juandelacruz-calvo/standing-desk-controller/(commit log)

2026-03-20 Initial commit: standing desk controller with HC-SR04 sensor, 4 buttons, EEPROM memory, closed-loop positioning, and 3D-printable enclosure. CC BY-NC-SA 4.0.
    [enclosure.scad]
2026-03-22 Add third memory button (MEM3) on pin D10
    Adds a third programmable height preset following the same click-to-recall / long-press-to-save pattern. Updates firmware, enclosure (5 buttons + label), and README documentation.
    Made-with: Cursor
    [enclosure.scad]
2026-03-29 Update configuration and code for motor control and button handling
    - Added .history/ and .vscode/ to .gitignore.
    - Changed upload and monitor ports in platformio.ini from COM4 to COM3.
    - Updated motor control logic in main.cpp to use pinMode for motor pins and improved button handling with event logging for better debugging.
2026-03-31 Update project for Wemos D1 Mini support and MQTT integration
    - Changed board configuration in platformio.ini from Arduino Nano to Wemos D1 Mini (ESP8266).
    - Updated README to reflect hardware changes and new features.
    - Added local WiFi/MQTT credentials handling in main.cpp with support for MQTT commands.
    - Adjusted pin assignments for the D1 Mini and updated serial communication speed to 115200 baud.
    - Included secrets.h for managing sensitive information.
2026-05-10 Refactor pin assignments and update sensor handling logic
    - Changed motor down pin from D1 to D8 and memory button pin from D8 to D1.
    - Increased height tolerance from 0.5 cm to 1.5 cm and sensor interval from 100 ms to 200 ms.
    - Added idle log interval for height reporting and improved height smoothing logic in readHeight function.
    - Updated serial output to reflect new pin assignments and current height readings.
    [main.cpp]
2026-05-19 Update platformio.ini and main.cpp for HCSR04 sensor integration and board configuration
    - Changed upload and monitor ports to COM5.
    - Updated library dependency from NewPing to HCSR04.
    - Added new environment configuration for Arduino Nano with specific build flags.
    - Refactored sensor handling logic to accommodate HCSR04 and adjusted maximum distance.
    - Modified motor control logic for improved safety and reliability.
    - Enhanced MQTT state publishing functionality with conditional compilation for WiFi support.
